cmbahadir/AIS-Receiver/README.md

# AIS Receiver by CMB

Please be aware that this project is still under construction. 

Required: https://github.com/KiCad/kicad-library
