cmbahadir/AIS-Receiver/BOM.xlsx

Sheet: Genel
RF - Si4464
Annotation | Value | Package | Digikey Part Number | Price (USD)
CR3 | 220pF | 1111 | Farnell - 1885462 | 2
LR2 | 240nH | 402 | 445-17063-1-ND (https://www.digikey.com/product-detail/en/tdk-corporation/MLK1005SR24JTD25/445-17063-1-ND/4869863) | 0.1
LR1 | 160nH | 805 | 490-16066-1-ND (https://www.digikey.com/product-detail/en/murata-electronics-north-america/LQW2BANR16J00L/490-16066-1-ND/6800731) | 0.53
CR2 | 6pF | 603 | 399-8734-1-ND (https://www.digikey.com/product-detail/en/kemet/CBR06C609BAGAC/399-8734-1-ND/3480322) | 0.55
CR1 | 12pF | 603 | 399-6184-1-ND (https://www.digikey.com/product-detail/en/kemet/CBR06C120JAGAC/399-6184-1-ND/2732158) | 0.42
 |  |  |  | 3.6
Annotation | Value | Package | Digikey Part Number | Price (USD)
C1 | 100pF | 603 | 399-1061-1-ND (https://www.digikey.com/product-detail/en/kemet/C0603C101J5GACTU/399-1061-1-ND/411336) | 0.1
C2 | 0.1uF | 603 | 311-1343-1-ND (https://www.digikey.com/product-detail/en/yageo/CC0603ZRY5V9BB104/311-1343-1-ND/2103127) | 0.1
C3 | 1uF | 603 | 1276-1946-1-ND (https://www.digikey.com/product-detail/en/samsung-electro-mechanics-america-inc/CL10B105KP8NNNC/1276-1946-1-ND/3890032) | 0.1
C4 | 1uF | 603 | 1276-1946-1-ND (https://www.digikey.com/product-detail/en/samsung-electro-mechanics-america-inc/CL10B105KP8NNNC/1276-1946-1-ND/3890032) | 0.1
C5 | 2.2uF | 603 | 587-2983-1-ND (https://www.digikey.com/product-detail/en/taiyo-yuden/LMK107B7225KA-T/587-2983-1-ND/2714176) | 0.19
C6 | 4.7uF | 603 | 1276-2087-1-ND (https://www.digikey.com/product-detail/en/samsung-electro-mechanics-america-inc/CL10B475KQ8NQNC/1276-2087-1-ND/3890173) | 0.1
C7 | 10uF | 805 | 490-10517-1-ND (https://www.digikey.com/product-detail/en/murata-electronics-north-america/GRM21BR71A106MA73L/490-10517-1-ND/5026448) | 0.21
C8 | 4.7uF | 603 | 1276-2087-1-ND (https://www.digikey.com/product-detail/en/samsung-electro-mechanics-america-inc/CL10B475KQ8NQNC/1276-2087-1-ND/3890173) | 0.1
C9 | 0.1uF | 603 | 311-1343-1-ND (https://www.digikey.com/product-detail/en/yageo/CC0603ZRY5V9BB104/311-1343-1-ND/2103127) | 0.1
C10 | 0.1uF | 603 | 311-1343-1-ND (https://www.digikey.com/product-detail/en/yageo/CC0603ZRY5V9BB104/311-1343-1-ND/2103127) | 0.1
C11 | 47pF | 603 | 399-15802-1-ND (https://www.digikey.com/product-detail/en/kemet/C0603C470K5RACAUTO/399-15802-1-ND/7516302) | 0.26
C12 | 47pF | 603 | 399-15802-1-ND (https://www.digikey.com/product-detail/en/kemet/C0603C470K5RACAUTO/399-15802-1-ND/7516302) | 0.26
C13 | 0.1uF | 603 | 311-1343-1-ND (https://www.digikey.com/product-detail/en/yageo/CC0603ZRY5V9BB104/311-1343-1-ND/2103127) | 0.1
C14 | 4.7uF | 603 | 1276-2087-1-ND (https://www.digikey.com/product-detail/en/samsung-electro-mechanics-america-inc/CL10B475KQ8NQNC/1276-2087-1-ND/3890173) | 0.1
C15 | 0.1uF | 603 | 311-1343-1-ND (https://www.digikey.com/product-detail/en/yageo/CC0603ZRY5V9BB104/311-1343-1-ND/2103127) | 0.1
C16 | 100pF | 603 | 399-1061-1-ND (https://www.digikey.com/product-detail/en/kemet/C0603C101J5GACTU/399-1061-1-ND/411336) | 0.1
C17 | 100nF | 603 | 311-1343-1-ND (https://www.digikey.com/product-detail/en/yageo/CC0603ZRY5V9BB104/311-1343-1-ND/2103127) | 0.1
C18 | 1uF | 603 | 1276-1946-1-ND (https://www.digikey.com/product-detail/en/samsung-electro-mechanics-america-inc/CL10B105KP8NNNC/1276-1946-1-ND/3890032) | 0.1
C19 | 22pF | 603 | 490-1411-1-ND (https://www.digikey.com/product-detail/en/murata-electronics-north-america/GRM1885C1H220JA01D/490-1411-1-ND/587624) | 0.1
C20 | 22pF | 603 | 490-1411-1-ND (https://www.digikey.com/product-detail/en/murata-electronics-north-america/GRM1885C1H220JA01D/490-1411-1-ND/587624) | 0.1
Total: |  |  |  | 2.52
Annotation | Value | Package | Digikey Part Number | Price (USD) | Remark
D1 | BAT20J | SOD-323 | 497-3381-1-ND | 0.46
D2 | LED-GREEN | 2.54mm - 1x2 | Direnc.net - DSTK5766 | 0.35
D3 | LED-RED | 2.54mm - 1x2 | Direnc.net - DSTK5766 | 0.35
D4 | LED-BLUE | 2.54mm - 1x2 | Direnc.net - DSTK5766 | 0.35
D5 | LED-YELLOW | 2.54mm - 1x2 | Direnc.net - DSTK5766 | 0.35
F1 | 500mA PTC | 1206 | NANOSMDH075F-02TR-ND | 0.91
J1 | CONN 02x03 | 2.54mm | Direnc.net - DSTK5766 | 0.35
J2 | CONN 01x20 | 2.54mm | Direnc.net - DSTK5766 | 0.35
J3 | CONN 01x20 | 2.54mm | Direnc.net - DSTK5766 | 0.35
J4 | USB Micro-B | Micro - B | 609-4613-1-ND (https://www.digikey.com/product-detail/en/amphenol-fci/10118192-0001LF/609-4613-1-ND/2785378) | 0.46
JP1 | 2.54mm Trough Hole Jumper 1x2 | 2.54mm | Direnc.net - DSTK5766 | 0.35
JP2 | 2.54mm Trough Hole Jumper 1x2 | 2.54mm | Direnc.net - DSTK5766 | 0.35
LIPO1 | JST-2.5mm Angled | JST - 2.5mm | Roboweb - RW-ML-1395 | 0.1 | Evdeki Pillerin Pin aralıkları?
P1 | Molex Microcoaxial RF | u.fl | H9161CT-ND | 1.31
Q2 | MBT3904DW1 - BJT | SOT-363 | MBT3904DW1T1GOSCT-ND | 0.22
Q1 | DMG2307L | SOT-23 | DMG2307L-7DICT-ND | 0.41
SW1 | Push Button | 4mm 6x6 | Direnc.net - 9712 | 0.15
SW2 | Push Button | 4mm 6x6 | Direnc.net - 9712 | 0.15
U1 | ESP32 WROOM | ESP32 Module | Direnc.net - DSTK6860 | 10
U2 | AP2112K | SOT-23-5 | AP2112K-3.3TRG1DICT-ND | 0.48
U3 | MCP73811T-420I/OT | SOT23 | MCP73811T-420I/OTCT-ND | 0.54
U4 | LIS331HH | 16-VFLGA | 497-10134-ND | 4.84 | Footprint Yok
U5 | FT231XS | SSOP-20 | 768-1129-1-ND | 2.12
U6 | Si4464 | 20-VFQFN | 336-2472-5-ND | 3.59
X1 | 30MHz | 4-SMD No Lead | CTX685CT-ND | 1.12 | Emin Olmak Gerekiyor
BATT | 3.7V - 1250mAH Li-Po | 25C Li-Po | Direnc.net - DSTK3799 | 10
Total: |  |  |  | 40.01
Annotation | Value | Package | Digikey Part Number | Price (USD)
R1 | 100R | 603 | 311-100HRCT-ND (https://www.digikey.com/product-detail/en/yageo/RC0603FR-07100RL/311-100HRCT-ND/729835) | 0.1
R2 | 10K | 603 | 311-10KGRCT-ND (https://www.digikey.com/product-detail/en/yageo/RC0603JR-0710KL/311-10KGRCT-ND/729647) | 0.1
R3 | 10K | 603 | 311-10KGRCT-ND (https://www.digikey.com/product-detail/en/yageo/RC0603JR-0710KL/311-10KGRCT-ND/729647) | 0.1
R4 | 20K | 603 | 311-20.0KHRCT-ND (https://www.digikey.com/product-detail/en/yageo/RC0603FR-0720KL/311-20.0KHRCT-ND/729987) | 0.1
R5 | 330R | 603 | 311-330GRCT-ND (https://www.digikey.com/product-detail/en/yageo/RC0603JR-07330RL/311-330GRCT-ND/729716) | 0.1
R6 | 4.7K | 603 | 311-4.7KGRCT-ND (https://www.digikey.com/product-detail/en/yageo/RC0603JR-074K7L/311-4.7KGRCT-ND/729732) | 0.1
R7 | 4.7K | 603 | 311-4.7KGRCT-ND (https://www.digikey.com/product-detail/en/yageo/RC0603JR-074K7L/311-4.7KGRCT-ND/729732) | 0.1
R8 | 100R | 603 | 311-100HRCT-ND (https://www.digikey.com/product-detail/en/yageo/RC0603FR-07100RL/311-100HRCT-ND/729835) | 0.1
R9 | 10K | 603 | 311-10KGRCT-ND (https://www.digikey.com/product-detail/en/yageo/RC0603JR-0710KL/311-10KGRCT-ND/729647) | 0.1
R10 | 1K | 603 | 311-1.0KGRCT-ND (https://www.digikey.com/product-detail/en/yageo/RC0603JR-071KL/311-1.0KGRCT-ND/729624) | 0.1
R11 | 10K | 603 | 311-10KGRCT-ND (https://www.digikey.com/product-detail/en/yageo/RC0603JR-0710KL/311-10KGRCT-ND/729647) | 0.1
R12 | 1K | 603 | 311-1.0KGRCT-ND (https://www.digikey.com/product-detail/en/yageo/RC0603JR-071KL/311-1.0KGRCT-ND/729624) | 0.1
R13 | 2K | 603 | 311-2.0KGRCT-ND (https://www.digikey.com/product-detail/en/yageo/RC0603JR-072KL/311-2.0KGRCT-ND/729673) | 0.1
R14 | 2K | 603 | 311-2.0KGRCT-ND (https://www.digikey.com/product-detail/en/yageo/RC0603JR-072KL/311-2.0KGRCT-ND/729673) | 0.1
R15 | 10K | 603 | 311-10KGRCT-ND (https://www.digikey.com/product-detail/en/yageo/RC0603JR-0710KL/311-10KGRCT-ND/729647) | 0.1
R16 | 330R | 603 | 311-330GRCT-ND (https://www.digikey.com/product-detail/en/yageo/RC0603JR-07330RL/311-330GRCT-ND/729716) | 0.1
R17 | 27R | 603 | 311-27GRCT-ND (https://www.digikey.com/product-detail/en/yageo/RC0603JR-0727RL/311-27GRCT-ND/729698) | 0.1
R18 | 27R | 603 | 311-27GRCT-ND (https://www.digikey.com/product-detail/en/yageo/RC0603JR-0727RL/311-27GRCT-ND/729698) | 0.1
R19 | 10K | 603 | 311-10KGRCT-ND (https://www.digikey.com/product-detail/en/yageo/RC0603JR-0710KL/311-10KGRCT-ND/729647) | 0.1
R20 | 100K | 603 | 311-100KGRCT-ND (https://www.digikey.com/product-detail/en/yageo/RC0603JR-07100KL/311-100KGRCT-ND/729645) | 0.1
R21 | 10K | 603 | 311-10KGRCT-ND (https://www.digikey.com/product-detail/en/yageo/RC0603JR-0710KL/311-10KGRCT-ND/729647) | 0.1
R22 | 100K | 603 | 311-100KGRCT-ND (https://www.digikey.com/product-detail/en/yageo/RC0603JR-07100KL/311-100KGRCT-ND/729645) | 0.1
Total: |  |  |  | 2.2

Sheet: Digikey
 |  |  |  |  |  |  | SMD
Value | Package | Digikey Part Number | Price (USD) | Amount | Total Price |  | Single Board | Total Price
22pF | 603 | 490-1411-1-ND (https://www.digikey.com/product-detail/en/murata-electronics-north-america/GRM1885C1H220JA01D/490-1411-1-ND/587624) | 0.1 | 10 | 1
220pF | 1111 | Farnell - 1885462 | 2 | 5 | 10 | 220pF | 1 | 2
240nH | 402 | 445-17063-1-ND (https://www.digikey.com/product-detail/en/tdk-corporation/MLK1005SR24JTD25/445-17063-1-ND/4869863) | 0.1 | 10 | 1 | 240nH | 1 | 0.1
160nH | 805 | 490-16066-1-ND (https://www.digikey.com/product-detail/en/murata-electronics-north-america/LQW2BANR16J00L/490-16066-1-ND/6800731) | 0.53 | 10 | 5.3 | 160nH | 1 | 0.53
6pF | 603 | 399-8734-1-ND (https://www.digikey.com/product-detail/en/kemet/CBR06C609BAGAC/399-8734-1-ND/3480322) | 0.55 | 10 | 5.5 | 6pF | 1 | 0.55
12pF | 603 | 399-6184-1-ND (https://www.digikey.com/product-detail/en/kemet/CBR06C120JAGAC/399-6184-1-ND/2732158) | 0.42 | 10 | 4.2 | 12pF | 1 | 0.42
100pF | 603 | 399-1061-1-ND (https://www.digikey.com/product-detail/en/kemet/C0603C101J5GACTU/399-1061-1-ND/411336) | 0.1 | 10 | 1 | 100pF | 2 | 0.2
0.1uF | 603 | 311-1343-1-ND (https://www.digikey.com/product-detail/en/yageo/CC0603ZRY5V9BB104/311-1343-1-ND/2103127) | 0.1 | 10 | 1 | 0.1uF | 4 | 0.4
1uF | 603 | 1276-1946-1-ND (https://www.digikey.com/product-detail/en/samsung-electro-mechanics-america-inc/CL10B105KP8NNNC/1276-1946-1-ND/3890032) | 0.1 | 10 | 1 | 1uF | 3 | 0.3
2.2uF | 603 | 587-2983-1-ND (https://www.digikey.com/product-detail/en/taiyo-yuden/LMK107B7225KA-T/587-2983-1-ND/2714176) | 0.19 | 10 | 1.9 | 2.2uF | 1 | 0.19
4.7uF | 603 | 1276-2087-1-ND (https://www.digikey.com/product-detail/en/samsung-electro-mechanics-america-inc/CL10B475KQ8NQNC/1276-2087-1-ND/3890173) | 0.1 | 10 | 1 | 4.7uF | 3 | 0.3
10uF | 805 | 490-10517-1-ND (https://www.digikey.com/product-detail/en/murata-electronics-north-america/GRM21BR71A106MA73L/490-10517-1-ND/5026448) | 0.21 | 10 | 2.1 | 10uF | 1 | 0.21
47pF | 603 | 399-15802-1-ND (https://www.digikey.com/product-detail/en/kemet/C0603C470K5RACAUTO/399-15802-1-ND/7516302) | 0.26 | 10 | 2.6 | 47pF | 2 | 0.52
100nF | 603 | 311-1343-1-ND (https://www.digikey.com/product-detail/en/yageo/CC0603ZRY5V9BB104/311-1343-1-ND/2103127) | 0.1 | 10 | 1 | 100nF | 1 | 0.1
BAT20J | SOD-323 | 497-3381-1-ND | 0.46 | 5 | 2.3 | BAT20J | 1 | 0.46
500mA PTC | 1206 | NANOSMDH075F-02TR-ND | 0.91 | 5 | 4.55 | 500mA PTC | 1 | 0.91
Molex Microcoaxial RF | u.fl | H9161CT-ND | 1.31 | 5 | 6.55 | Molex Microcoaxial RF | 1 | 1.31
MBT3904DW1 - BJT | SOT-363 | MBT3904DW1T1GOSCT-ND | 0.22 | 5 | 1.1 | MBT3904DW1 - BJT | 1 | 0.22
DMG2307L | SOT-23 | DMG2307L-7DICT-ND | 0.41 | 5 | 2.05 | DMG2307L | 1 | 0.41
AP2112K | SOT-23-5 | AP2112K-3.3TRG1DICT-ND | 0.48 | 5 | 2.4 | AP2112K | 1 | 0.48
LIS331HH | 16-VFLGA | 497-10134-ND | 4.84 | 5 | 24.2 | LIS331HH | 1 | 4.84
Si4464 | 20-VFQFN | 336-2472-5-ND | 3.59 | 5 | 17.95 | Si4464 | 1 | 3.59
30MHz | 4-SMD No Lead | CTX685CT-ND | 1.12 | 5 | 5.6 | 30MHz | 1 | 1.12
100R | 603 | 311-100HRCT-ND (https://www.digikey.com/product-detail/en/yageo/RC0603FR-07100RL/311-100HRCT-ND/729835) | 0.1 | 10 | 1 | 100R | 2 | 0.2
20K | 603 | 311-20.0KHRCT-ND (https://www.digikey.com/product-detail/en/yageo/RC0603FR-0720KL/311-20.0KHRCT-ND/729987) | 0.1 | 10 | 1 | 20K | 1 | 0.1
2K | 603 | 311-2.0KGRCT-ND (https://www.digikey.com/product-detail/en/yageo/RC0603JR-072KL/311-2.0KGRCT-ND/729673) | 0.1 | 10 | 1 | 2K | 2 | 0.2
330R | 603 | 311-330GRCT-ND (https://www.digikey.com/product-detail/en/yageo/RC0603JR-07330RL/311-330GRCT-ND/729716) | 0.1 | 10 | 1 | 330R | 2 | 0.2
27R | 603 | 311-27GRCT-ND (https://www.digikey.com/product-detail/en/yageo/RC0603JR-0727RL/311-27GRCT-ND/729698) | 0.1 | 10 | 1 | 27R | 2 | 0.2
100K | 603 | 311-100KGRCT-ND (https://www.digikey.com/product-detail/en/yageo/RC0603JR-07100KL/311-100KGRCT-ND/729645) | 0.1 | 10 | 1 | 100K | 2 | 0.2
Molex Micro USB | Micro B | WM17143CT-ND | 0.74 | 5 | 3.7 | Molex Micro USB | 1 | 0.74
Total: |  |  | 0.6 | 235 | 115 | 10K | 7 | 0.7
 |  |  |  |  |  | ESP32 WROOM | 1 | 10
 |  |  |  |  |  | FT231XS | 1 | 2.12
 |  |  |  |  |  | LED | 4 | 1.5
 |  |  |  |  |  | HEADER | 1 | 0,5
 |  |  |  |  |  | JST CONN. | 1 | 0.5
 |  |  |  |  |  | ON-OFF SWITCH | 1 | 2
 |  |  |  |  |  | MCP73831T | 1 | 0.7
 |  |  |  |  |  | 1K | 2 | 0.2
 |  |  |  |  |  | 4.7K | 2 | 0.2
 |  |  |  |  |  | Push Button | 3 | 0,5
 |  |  |  |  |  | Total: |  | 38.92

Sheet: Maliyet
 | Fiyat (TL) | Tek Board Maliyet (USD)
OSH Park PCB Baskı | 250 | SMD | 38.92
PCBWay PCB Baskı | 36 | Pil | 6
Direnc.net Malzemeler | 118 | Kablo (sma-ufl) | 5
EXPKits Malzemeler | 37 | Kutu | 2
ESP32 Development Board | 19 | Etiket | 1
Si4463 Development Board | 19 | Total: | 52.92
Digikey Sipariş (10 Adetlik) | 475
Stencil (Çelik Elek) | 160
Toplam: | 1114
