cmbahadir/AIS-Receiver/(list of files, cad)

Other CAD files:
Datasheet/Box/SE-218-P-1.DXF
Datasheet/Box/SE-218-P-2.DXF
Datasheet/Box/SE-218-0-0-D-0.DXF
