cmbahadir/AIS-Receiver/Schematic.pdf

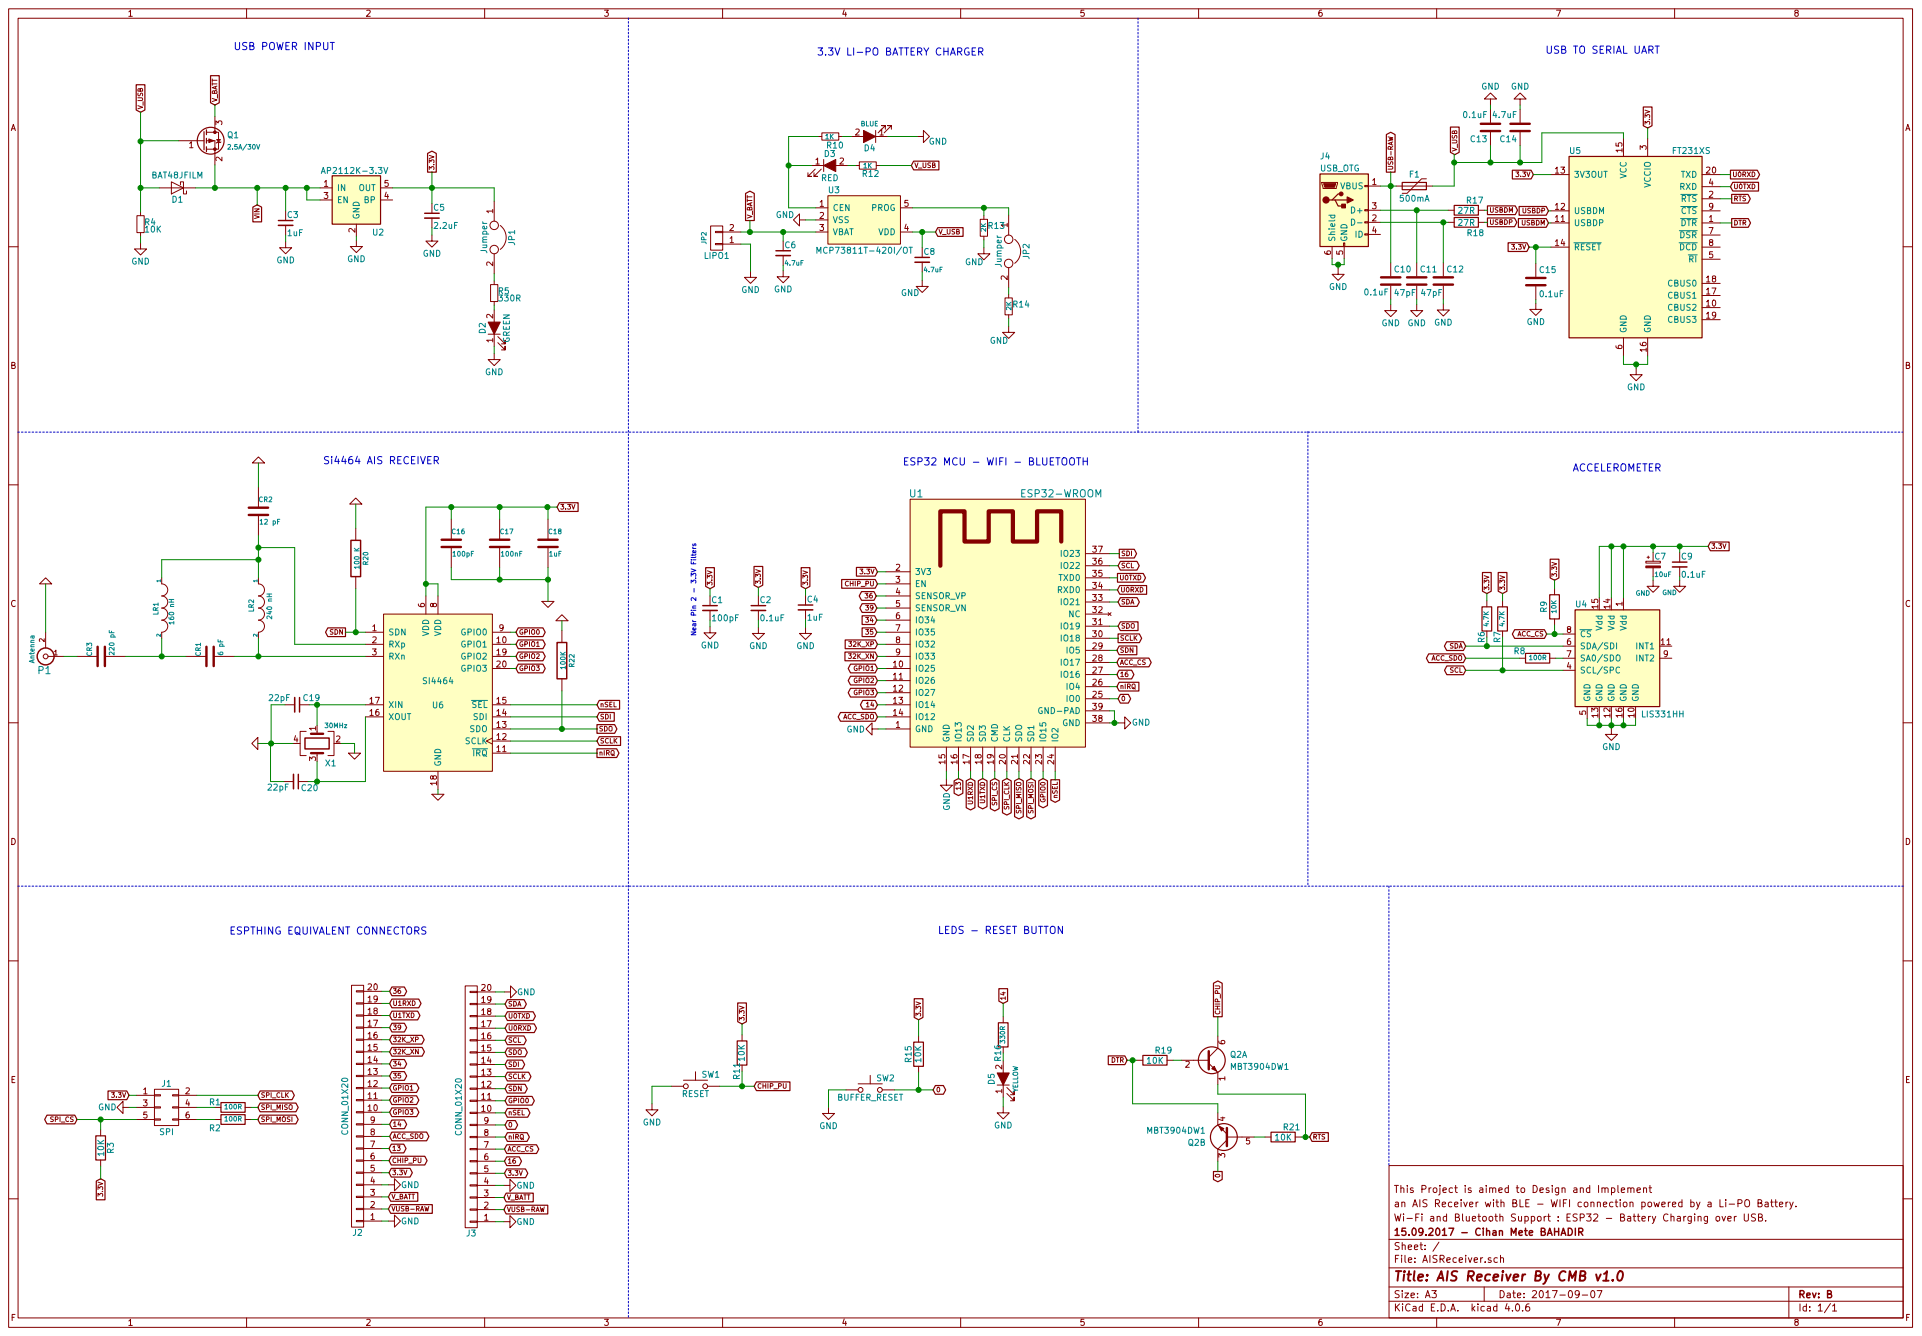
[picture p6: page 1]

1 2 D2 GREEN GND GND GND GND GND V_USB V_BATT VIN 3.3V C4

5 SDA/SDI 6 SA0/SDO 7 CS 8

This Project is aimed to Design and Implement
an AIS Receiver with BLE - WIFI connection powered by a Li-PO Battery.
File: AISReceiver.sch Sheet: / 15.09.2017 - Cihan Mete BAHADIR Wi-Fi and Bluetooth Support : ESP32 - Battery Charging over USB.

Id: 1/1 Title: AIS Receiver By CMB v1.0
