cmbahadir/AIS-Receiver/Plots/AISReceiver.pdf

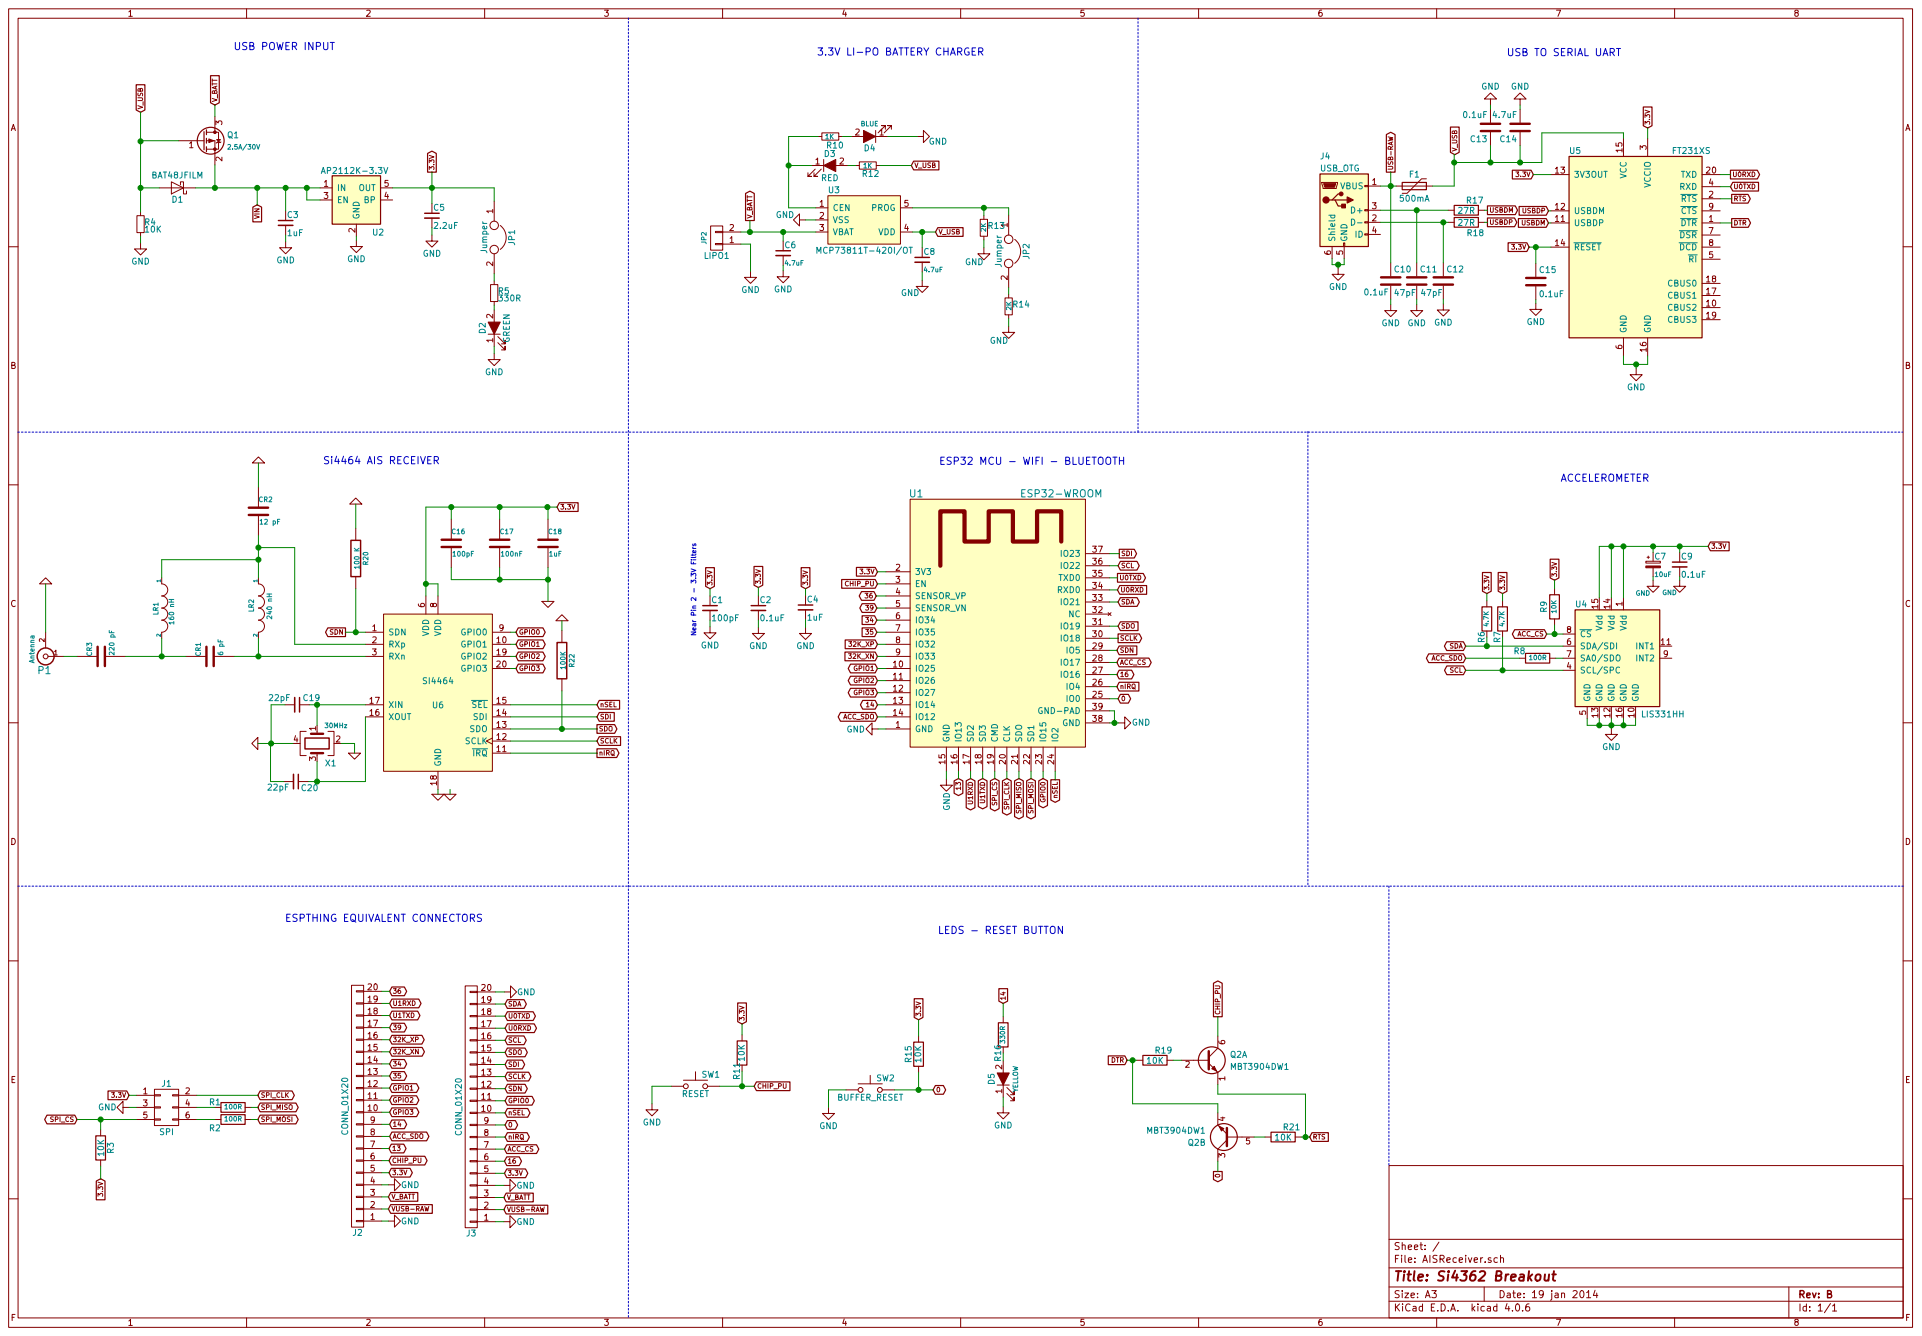
[picture p7: page 1]

1 2 D2 GREEN GND GND GND GND GND V_USB V_BATT VIN 3.3V C4

5 SDA/SDI 6 SA0/SDO 7 CS 8

Id: 1/1 Title: Si4362 Breakout File: AISReceiver.sch Sheet: /
