cmbahadir/AIS-Receiver/Plots/AISReceiver-B.Cu.pdf

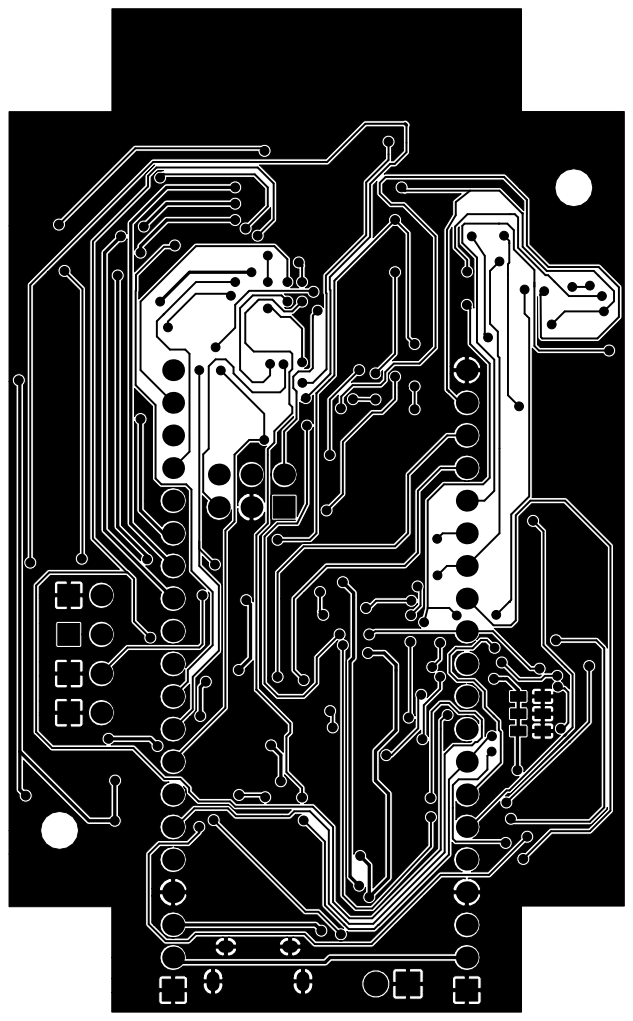
[picture p8: page 1]
