cmbahadir/AIS-Receiver/Plots/AISReceiver-B.SilkS.pdf

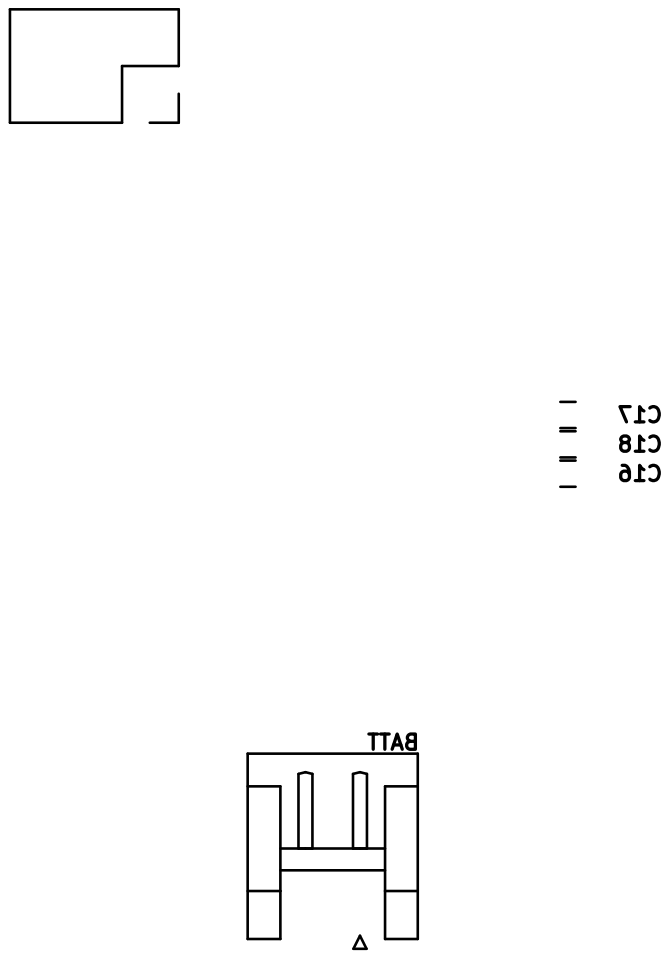
[picture p9: page 1]
