cmbahadir/AIS-Receiver/Plots/AISReceiver-Edge.Cuts.pdf

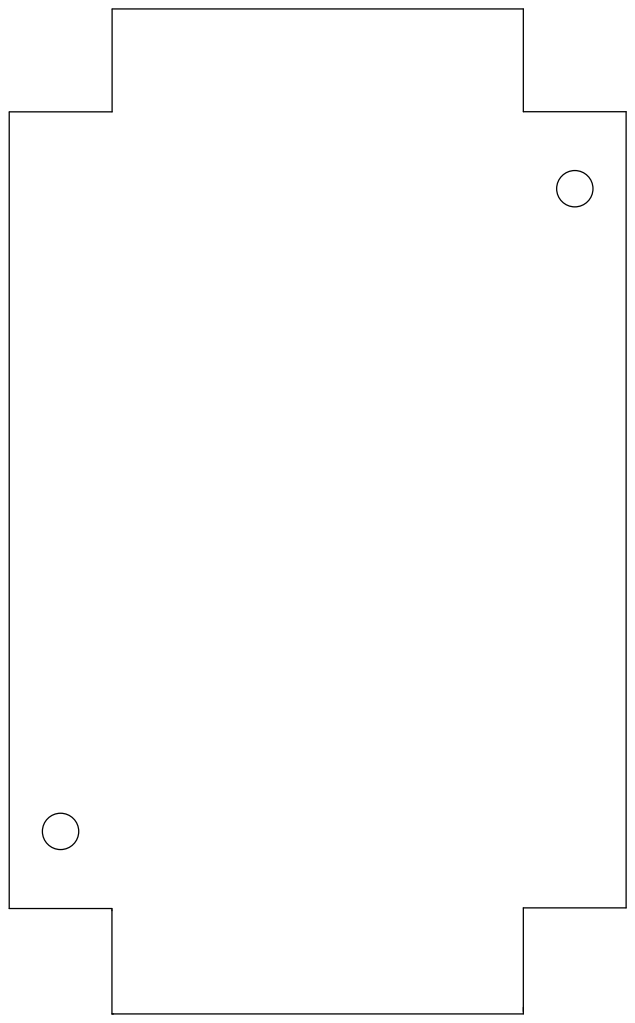
[picture p10: page 1]
