cmbahadir/AIS-Receiver/Plots/AISReceiver-F.Cu.pdf

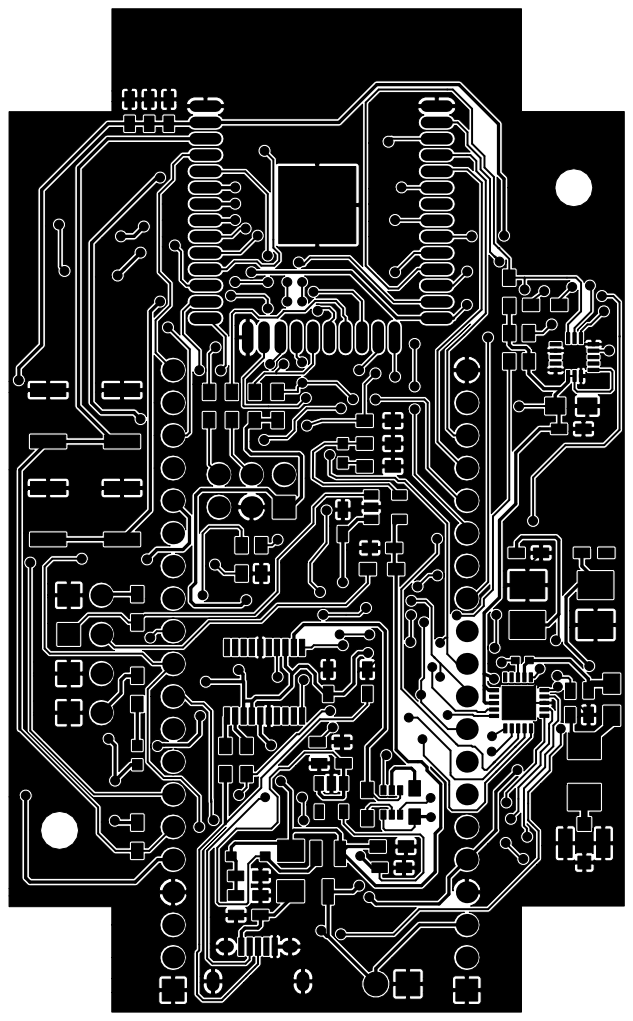
[picture p11: page 1]
