cmbahadir/AIS-Receiver/Plots/AISReceiver-F.SilkS.pdf

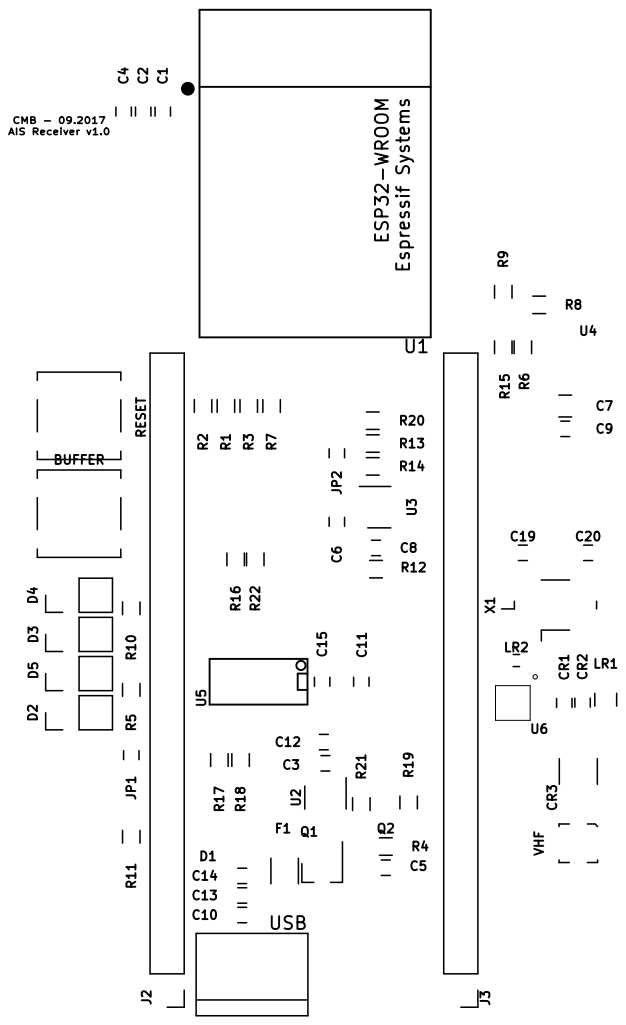
[picture p12: page 1]
