cmbahadir/AIS-Receiver/Project/AISReceiver.kicad_pcb

## KiCad design Project/AISReceiver.kicad_pcb (2018-04-05)

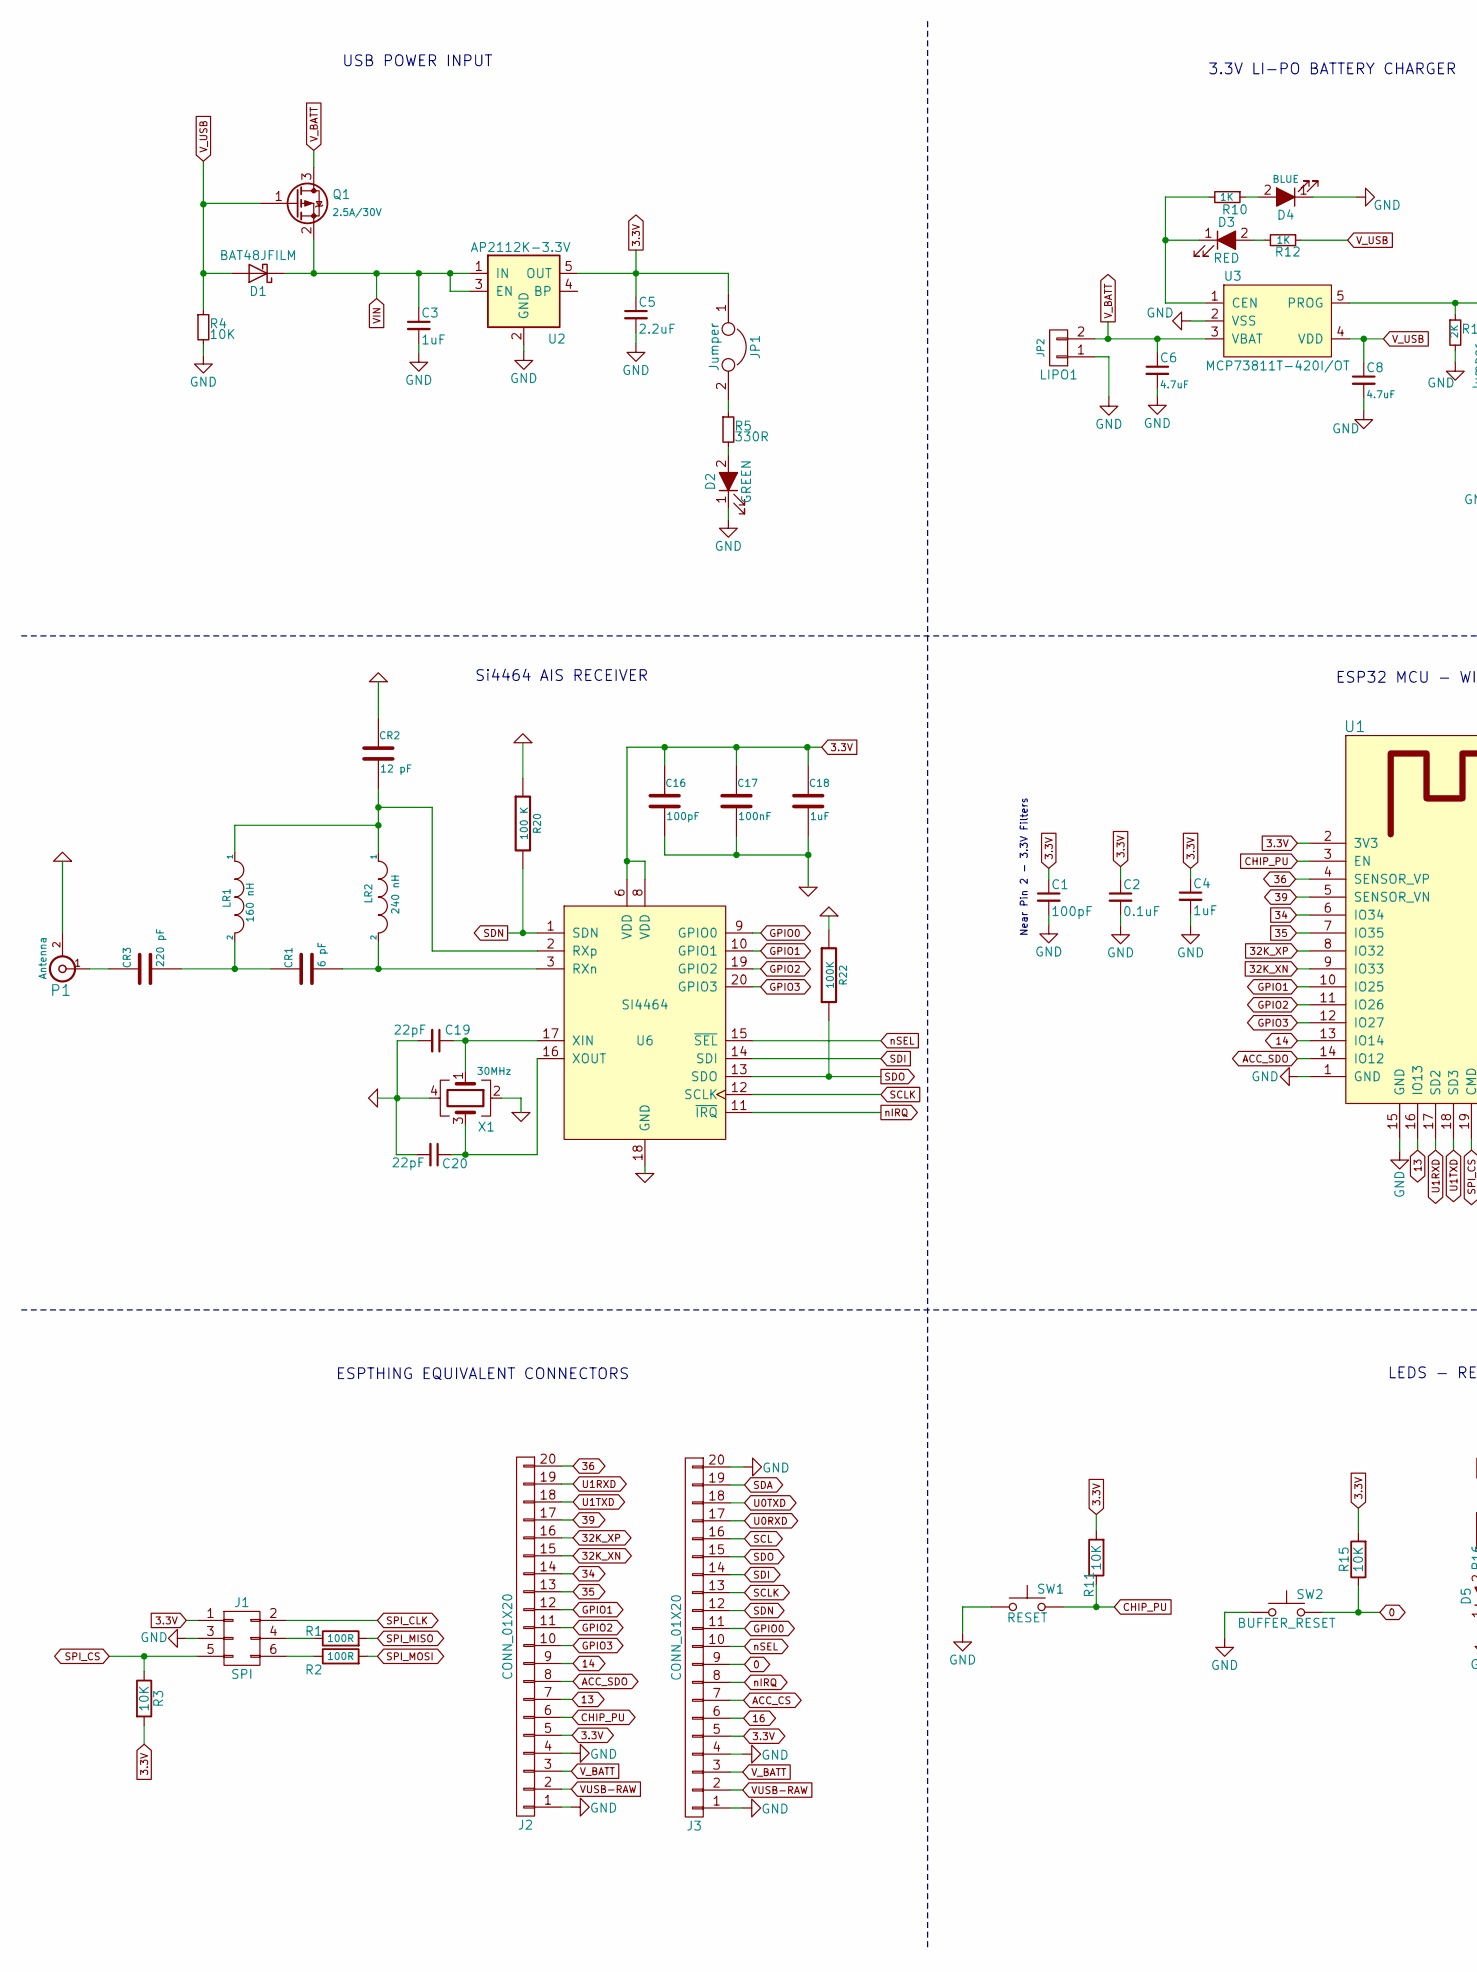
[picture p13: schematic AISReceiver.sch, AIS Receiver By CMB v1.0, part in row 1, column 1]

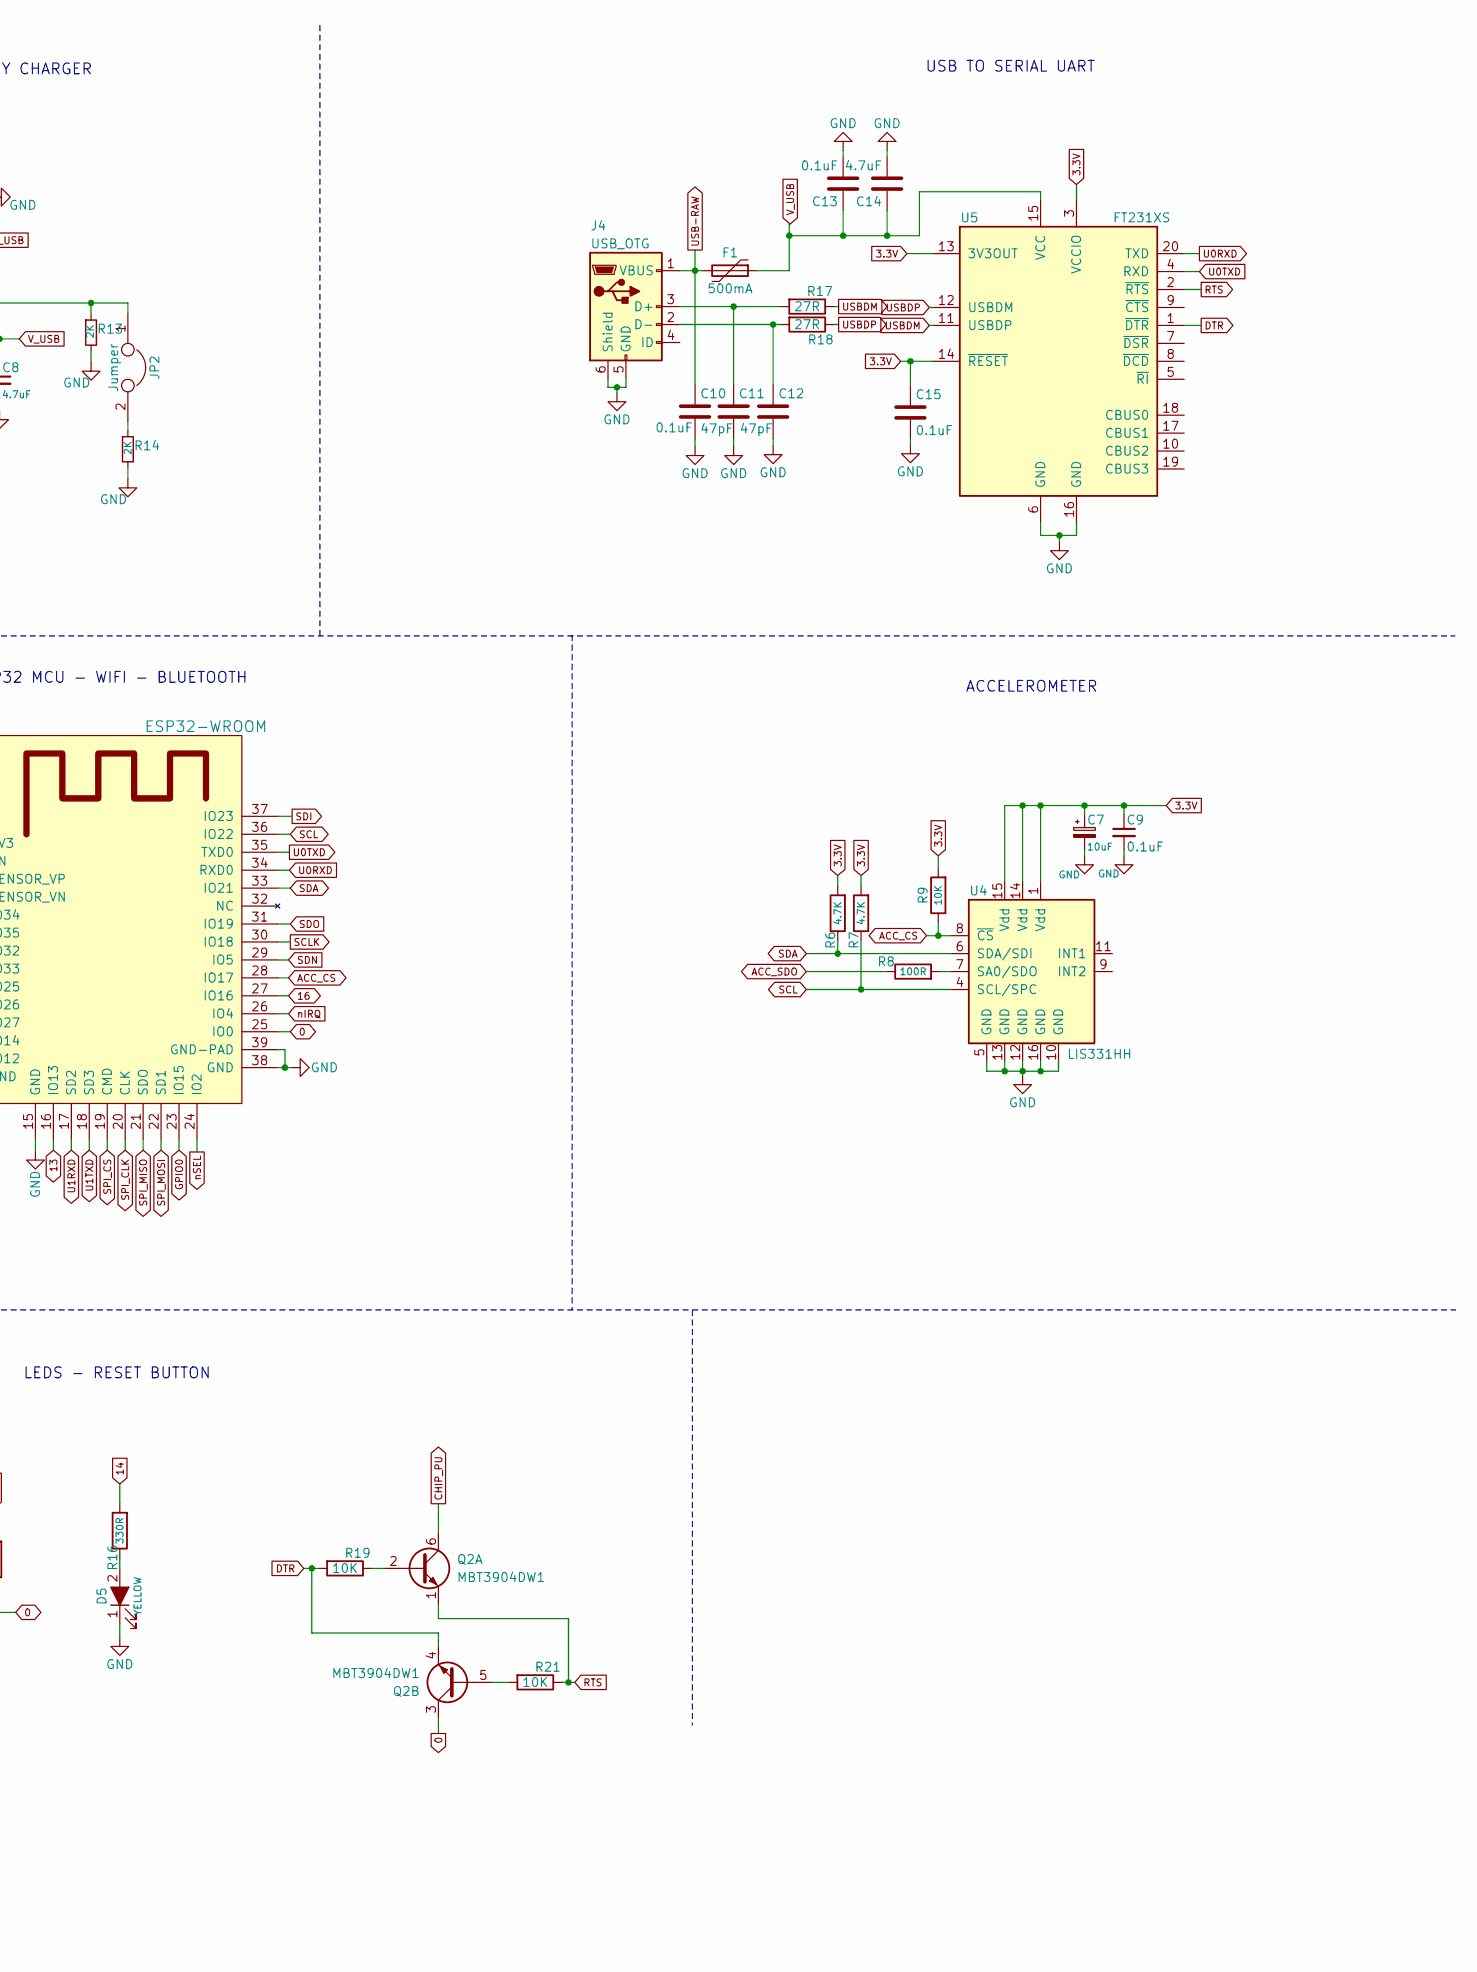
[picture p14: schematic AISReceiver.sch, AIS Receiver By CMB v1.0, part in row 1, column 2]

Parts:
C1, C16: 100pF; C_0603_HandSoldering
C2, C9, C10, C13, C15: 0.1uF; C_0603_HandSoldering
C3, C4, C18: 1uF; C_0603_HandSoldering
C5: 2.2uF; C_0603_HandSoldering
C6, C8, C14: 4.7uF; C_0603_HandSoldering
C7: 10uF; C_0805_HandSoldering
C11, C12: 47pF; C_0603_HandSoldering
C17: 100nF; C_0603_HandSoldering
C19, C20: 22pF; C_0603_HandSoldering
CR1: 6 pF; C_0603_HandSoldering
CR2: 12 pF; C_0603_HandSoldering
CR3: 220 pF; C_1210_HandSoldering
D1: BAT48JFILM; SOD-323
D2: GREEN; Pin_Header_Straight_1x02_Pitch2.54mm
D3: RED; Pin_Header_Straight_1x02_Pitch2.54mm
D4: BLUE; Pin_Header_Straight_1x02_Pitch2.54mm
D5: YELLOW; Pin_Header_Straight_1x02_Pitch2.54mm
F1: 500mA; Fuse_SMD1206_Wave
J1: SPI; Pin_Header_Angled_2x03_Pitch2.54mm
J2, J3: CONN_01X20; Pin_Header_Straight_1x20_Pitch2.54mm
J4: USB_OTG; USB_Micro-B
JP1, JP2: Jumper; C_0603
LIPO1: JP2; JST_EH_S02B-EH_02x2.50mm_Angled
LR1: 160 nH; C_0805_HandSoldering
LR2: 240 nH; C_0402
P1: Antenna; Molex_Microcoaxial_RF
Q1: 2.5A/30V; SOT-23_Handsoldering
Q2: MBT3904DW1; SOT-363
R1, R2, R8: 100R; R_0603_HandSoldering
R3, R4, R9, R11, R15, R19, R21: 10K; R_0603_HandSoldering
R5, R16: 330R; R_0603_HandSoldering
R6, R7: 4.7K; R_0603_HandSoldering
R10, R12: 1K; R_0603_HandSoldering
R13, R14: 2K; R_0603_HandSoldering
R17, R18: 27R; R_0603_HandSoldering
R20: 100 K; R_0603_HandSoldering
R22: 100K; R_0603_HandSoldering
SW1: RESET; SW_SPST_B3SL-1002P
SW2: BUFFER_RESET; SW_SPST_B3SL-1002P
U1: ESP32-WROOM
U2: AP2112K-3.3V; SOT-23-5
U3: MCP73811T-420I/OT; SOT-23-5
U4: LIS331HH; LGA-16-3x3
U5: FT231XS; SSOP-20
U6: SI4464; Si4464
X1: 30MHz; Crystal_SMD_0603-4pin_6.0x3.5mm_HandSoldering

Connections:
0: J3.9, Q2.3 (C2), R15.1, SW2.2, U1.25 (IO0); also elsewhere on the board
3.3V: C1.1, C2.1, C4.1, C5.1, C7.1, C9.1, C15.1, C16.1, C17.1, C18.1, J1.1, J2.5, J3.5, JP1.1, R3.2, R6.2, R7.2, R9.2, R11.2, R15.2, U1.2 (3V3), U2.5 (OUT), U4.1 (Vdd), U4.14 (Vdd), U4.15 (Vdd), U5.3 (VCCIO), U5.13 (3V3OUT), U5.14 (~RESET), U6.6 (VDD), U6.8 (VDD)
13: J2.7, U1.16 (IO13)
14: J2.9, R16.2, U1.13 (IO14)
16: J3.6, U1.27 (IO16)
32K_XN: J2.15, U1.9 (IO33)
32K_XP: J2.16, U1.8 (IO32)
34: J2.14, U1.6 (IO34)
35: J2.13, U1.7 (IO35)
36: J2.20, U1.4 (SENSOR_VP)
39: J2.17, U1.5 (SENSOR_VN)
ACC_CS: J3.7, R9.1, U1.28 (IO17), U4.8 (~CS)
ACC_SDO: J2.8, R8.1, U1.14 (IO12)
CHIP_PU: J2.6, Q2.6 (C1), R11.1, SW1.2, U1.3 (EN); also elsewhere on the board
DTR: Q2.4 (E2), R19.2, U5.1 (~DTR)
GND: C1.2, C2.2, C3.2, C4.2, C5.2, C6.2, C7.2, C8.2, C9.2, C10.2, C11.2, C12.2, C13.2, C14.2, C15.2, C16.2, C17.2, C18.2, C19.2, CR2.1, D2.1 (K), D4.1 (K), D5.1 (K), J1.3, J2.1, J2.4, J3.1, J3.4, J3.20, J4.5 (GND), J4.6 (Shield), LIPO1.1, P1.2 (Ext), R4.2, R13.2, R14.2, R20.1, R22.1, SW1.1, SW2.1, U1.1 (GND), U1.15 (GND), U1.38 (GND), U1.39 (GND-PAD), U2.2 (GND), U3.2 (VSS), U4.5 (GND), U4.10 (GND), U4.12 (GND), U4.13 (GND), U4.16 (GND), U5.6 (GND), U5.16 (GND), U6.18 (GND), X1.2, X1.4; also elsewhere on the board
GPIO0: J3.11, U1.23 (IO15), U6.9 (GPIO0)
GPIO1: J2.12, U1.10 (IO25), U6.10 (GPIO1)
GPIO2: J2.11, U1.11 (IO26), U6.19 (GPIO2)
GPIO3: J2.10, U1.12 (IO27), U6.20 (GPIO3)
unnamed 20: C11.1, J4.3 (D+), R17.2; also elsewhere on the board
unnamed 21: C12.1, J4.2 (D-), R18.2; also elsewhere on the board
unnamed: C19.1, U6.17 (XIN), X1.1
unnamed: C20.1, U6.16 (XOUT), X1.3
unnamed: CR1.1, CR3.2, LR1.2
unnamed: CR1.2, LR2.2, U6.3 (RXn)
unnamed: CR2.2, LR1.1, LR2.1, U6.2 (RXp)
unnamed 28: CR3.1, P1.1 (In); also elsewhere on the board
unnamed: D2.2 (A), R5.2
unnamed: D3.1 (K), R10.2, U3.1 (CEN)
unnamed: D3.2 (A), R12.2
unnamed: D4.2 (A), R10.1
unnamed: D5.2 (A), R16.1
unnamed: J1.4, R1.1
unnamed: J1.6, R2.1
unnamed: JP1.2, R5.1
unnamed: JP2.1, R13.1, U3.5 (PROG)
unnamed: JP2.2, R14.1
unnamed: Q2.2 (B1), R19.1
unnamed: Q2.5 (B2), R21.2
unnamed: R8.2, U4.7 (SA0/SDO)
RTS: Q2.1 (E1), R21.1, U5.2 (~RTS)
SCL: J3.16, R7.1, U1.36 (IO22), U4.4 (SCL/SPC)
SCLK: J3.13, U1.30 (IO18), U6.12 (SCLK)
SDA: J3.19, R6.1, U1.33 (IO21), U4.6 (SDA/SDI)
SDI: J3.14, U1.37 (IO23), U6.14 (SDI)
SDN: J3.12, R20.2, U1.29 (IO5), U6.1 (SDN)
SDO: J3.15, R22.2, U1.31 (IO19), U6.13 (SDO)
SPI_CLK: J1.2, U1.20 (CLK)
SPI_CS: J1.5, R3.1, U1.19 (CMD)
SPI_MISO: R1.2, U1.21 (SDO)
SPI_MOSI: R2.2, U1.22 (SD1)
U0RXD: J3.17, U1.34 (RXD0), U5.20 (TXD)
U0TXD: J3.18, U1.35 (TXD0), U5.4 (RXD)
U1RXD: J2.19, U1.17 (SD2)
U1TXD: J2.18, U1.18 (SD3)
USB-RAW: C10.1, F1.2, J4.1 (VBUS); also elsewhere on the board
USBDM: R17.1, U5.11 (USBDP)
USBDP: R18.1, U5.12 (USBDM)
VIN: C3.1, D1.1 (K), Q1.2 (S), U2.1 (IN), U2.3 (EN)
VUSB-RAW: J2.2, J3.2
V_BATT: C6.1, J2.3, J3.3, LIPO1.2, Q1.3 (D), U3.3 (VBAT); also elsewhere on the board
V_USB: C8.1, C13.1, C14.1, D1.2 (A), F1.1, Q1.1 (G), R4.1, R12.1, U3.4 (VDD), U5.15 (VCC)
nIRQ: J3.8, U1.26 (IO4), U6.11 (~IRQ)
nSEL: J3.10, U1.24 (IO2), U6.15 (~SEL)

Notes on the sheet:
Near Pin 2 - 3.3V Filters
USB POWER INPUT
3.3V LI-PO BATTERY CHARGER
USB TO SERIAL UART
ACCELEROMETER
ESP32 MCU - WIFI - BLUETOOTH
Si4464 AIS RECEIVER
ESPTHING EQUIVALENT CONNECTORS
LEDS - RESET BUTTON

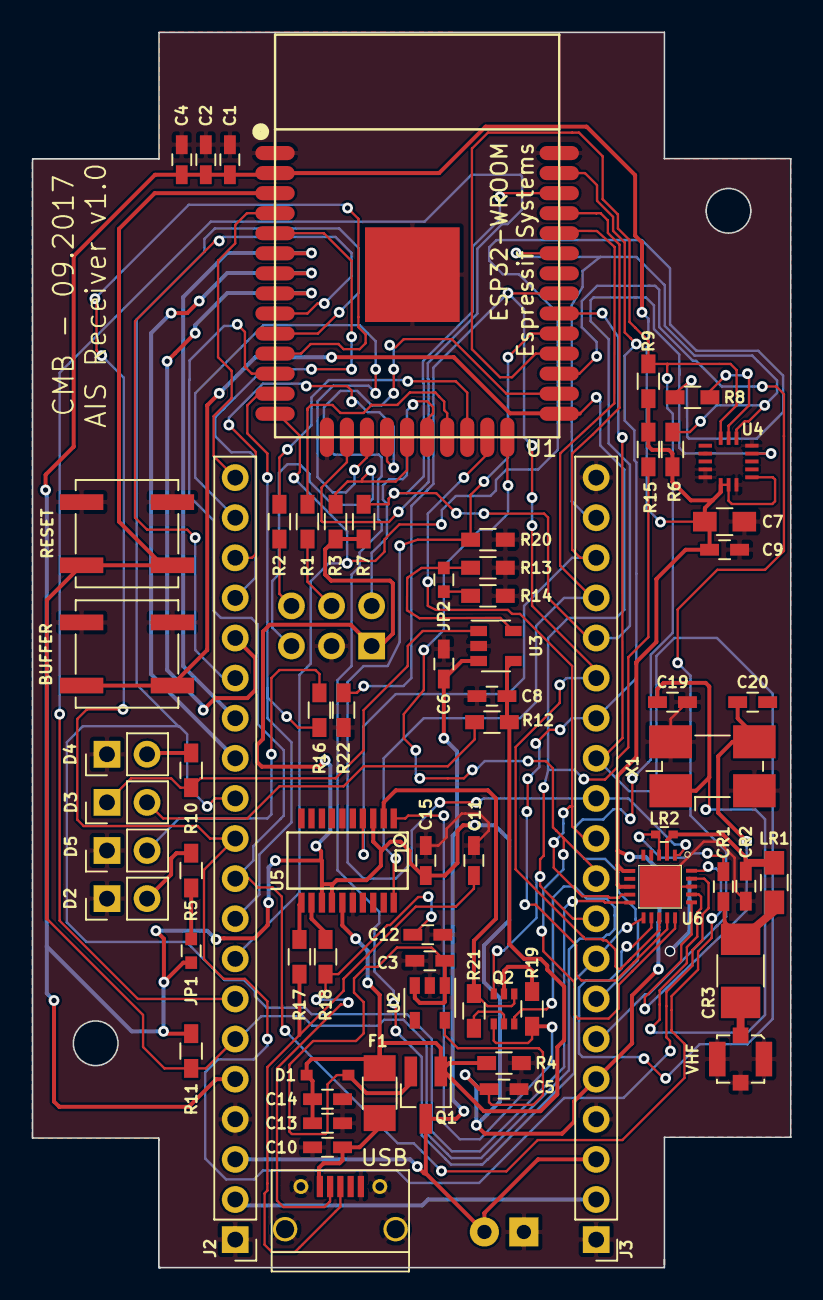
[picture p15: board AISReceiver.kicad_pcb from above]

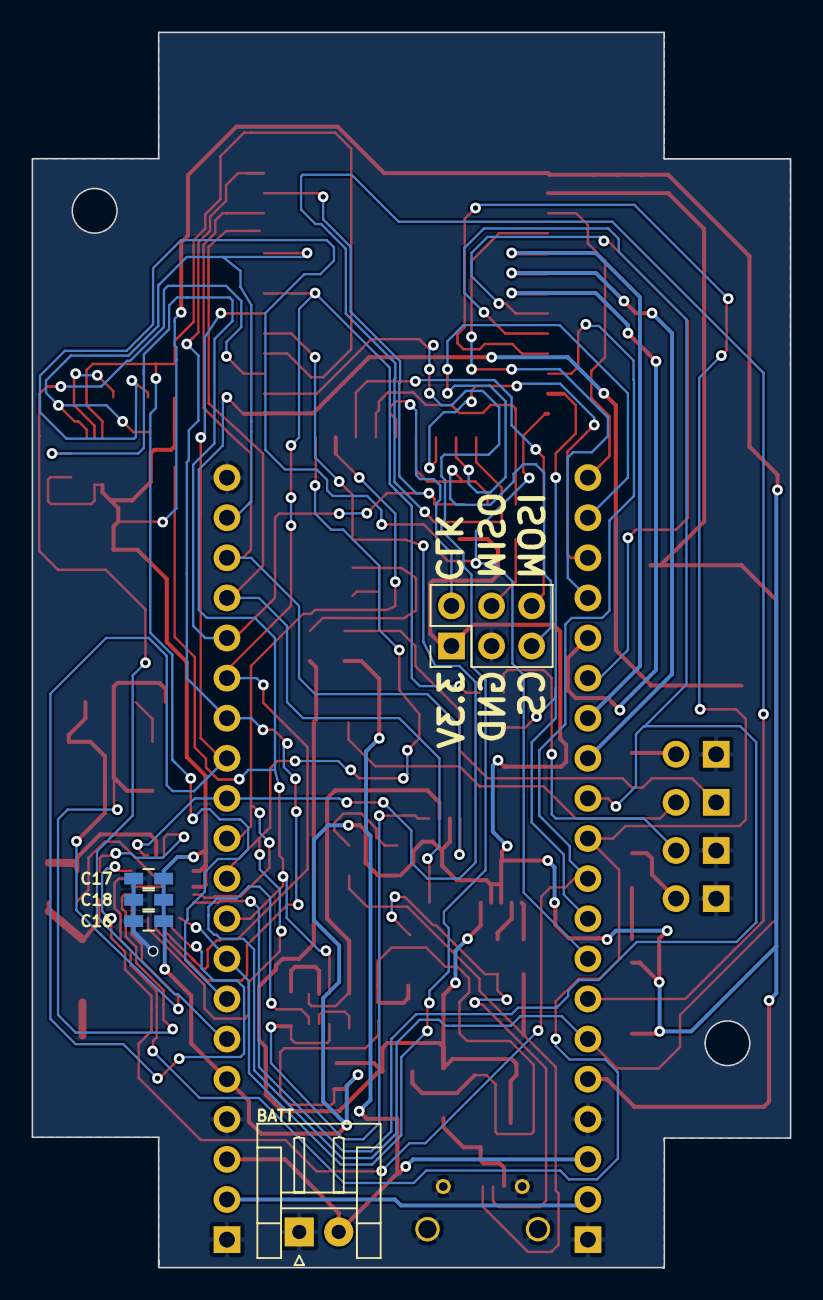
[picture p16: board AISReceiver.kicad_pcb from below]

Board: 2 copper layers, 48.0 x 78.2 mm, 73 parts (5 on the bottom side), 65 nets.

Other parts of the board:
BATT: JP2; JST_EH_S02B-EH_02x2.50mm_Angled
BUFFER: BUFFER_RESET; SW_SPST_B3SL-1002P
J5: CONN_01X01; microVia
RESET: RESET; SW_SPST_B3SL-1002P
USB: USB_OTG; USB_Micro-B
VHF: Antenna; Molex_Microcoaxial_RF

Their connections:
0: BUFFER.2; also elsewhere on the board
CHIP_PU: RESET.2; also elsewhere on the board
GND: BATT.1, BUFFER.1, RESET.1, USB.5, USB.6, VHF.2; also elsewhere on the board
unnamed 20: USB.3; also elsewhere on the board
unnamed 21: USB.2; also elsewhere on the board
unnamed 28: VHF.1; also elsewhere on the board
USB-RAW: USB.1; also elsewhere on the board
V_BATT: BATT.2; also elsewhere on the board
